lancas17/nrf52-controller/nrf52-controller.kicad_pcb

## KiCad design nrf52-controller.kicad_pcb (2024-05-02)

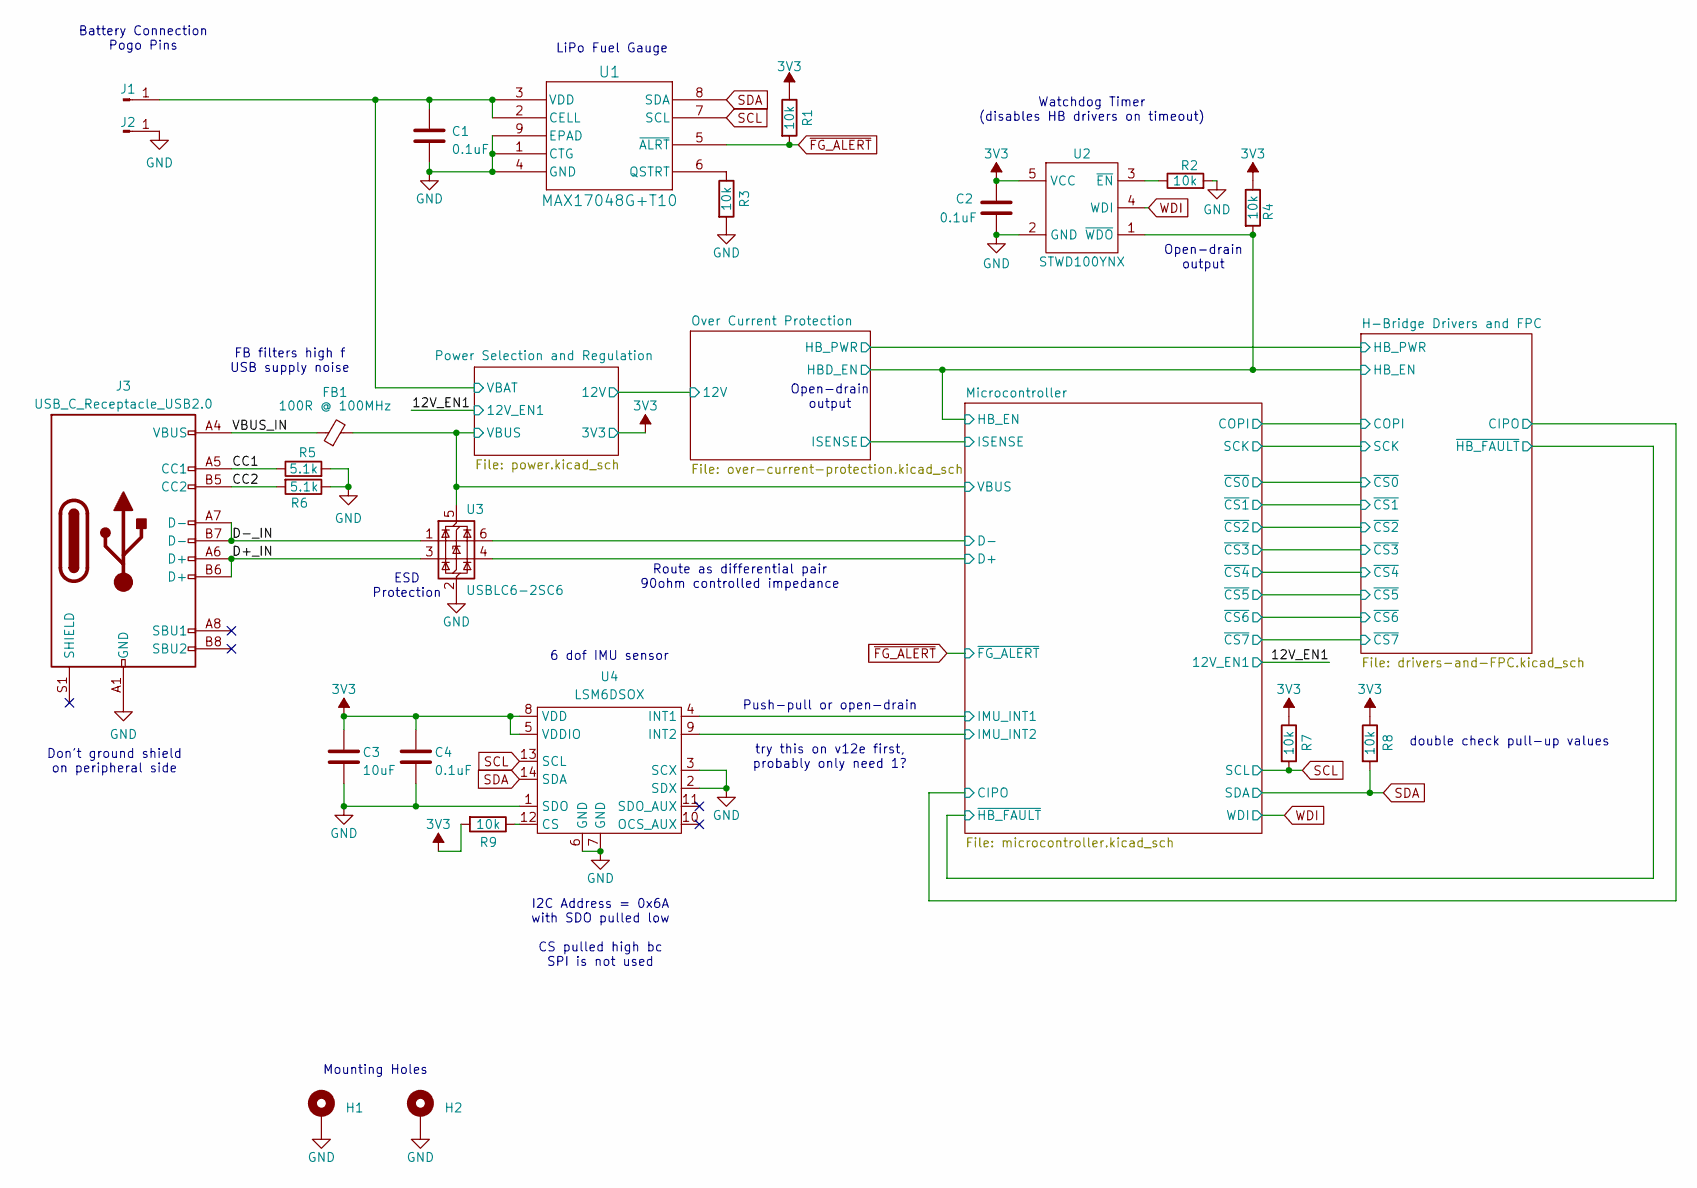
[picture p1: schematic nrf52-controller.kicad_sch]

Parts:
C1, C2, C4: 0.1uF; C_0402_1005Metric; JLCPCB Part # C880603
C3: 10uF; C_0402_1005Metric; JLCPCB Part # C15525
FB1: 100R @ 100MHz; C_0805_2012Metric; JLCPCB Part # C1015
H1, H2: MountingHole_Pad; MountingHole_1.8mm_M1.6_Pad_TopBottom
J1, J2: Conn_01x01_Pin; POGO_2mm-base_0.9mm-through-hole; JLCPCB Part # C5157348
J3: USB_C_Receptacle_USB2.0; USB_C_Receptacle_G-Switch_GT-USB-7010ASV; JLCPCB Part # C2988369
R1, R2, R3, R4, R7, R8, R9: 10k; R_0402_1005Metric; JLCPCB Part # C25744
R5, R6: 5.1k; R_0402_1005Metric; JLCPCB Part # C25905
U1: MAX17048G+T10; 21-0168E_T822-3_MXM; JLCPCB Part # C2682616
U2: STWD100YNX; SOT-23-5; JLCPCB Part # C1354132
U3: USBLC6-2SC6; SOT-23-6
U4: LSM6DSOX; LGA-14L_STM; JLCPCB Part # C481766

Connections:
3V3: C2.1, C3.1, C4.1, R1.1, R4.1, R7.1, R8.1, R9.2, U2.5 (VCC), U4.5 (VDDIO), U4.8 (VDD); also elsewhere on the board
/CC1: J3.A5 (CC1), R5.1
/CC2: J3.B5 (CC2), R6.2
/D+_IN: J3.A6 (D+), J3.B6 (D+), U3.3 (I/O2)
/D-_IN: J3.A7 (D-), J3.B7 (D-), U3.1 (I/O1)
/H-Bridge Drivers and FPC/HB_EN: R4.2, U2.1 (~WDO); also elsewhere on the board
/Microcontroller/D+: U3.4 (I/O2); also elsewhere on the board
/Microcontroller/D-: U3.6 (I/O1); also elsewhere on the board
/Microcontroller/IMU_INT1: U4.4 (INT1); also elsewhere on the board
/Microcontroller/IMU_INT2: U4.9 (INT2); also elsewhere on the board
/Microcontroller/VBUS: FB1.2, U3.5 (VBUS); also elsewhere on the board
/Power Selection and Regulation/VBAT: C1.1, J1.1, U1.2 (CELL), U1.3 (VDD); also elsewhere on the board
/VBUS_IN: FB1.1, J3.A4 (VBUS), J3.A9 (VBUS), J3.B4 (VBUS), J3.B9 (VBUS)
GND: C1.2, C2.2, C3.2, C4.2, H1.1, H2.1, J2.1, J3.A1 (GND), J3.A12 (GND), J3.B1 (GND), J3.B12 (GND), R2.2, R3.2, R5.2, R6.1, U1.1 (CTG), U1.4 (GND), U1.9 (EPAD), U2.2 (GND), U3.2 (GND), U4.1 (SDO), U4.2 (SDX), U4.3 (SCX), U4.6 (GND), U4.7 (GND); also elsewhere on the board
unnamed: R3.1, U1.6 (QSTRT)
unnamed: R2.1, U2.3 (~EN)
unnamed: R9.1, U4.12 (CS)
SCL: R7.2, U1.7 (SCL), U4.13 (SCL); also elsewhere on the board
SDA: R8.2, U1.8 (SDA), U4.14 (SDA); also elsewhere on the board
WDI: U2.4 (WDI); also elsewhere on the board
~FG_ALERT: R1.2, U1.5 (~ALRT); also elsewhere on the board

Notes on the sheet:
Watchdog Timer (disables HB drivers on timeout)
try this on v12e first, probably only need 1?
double check pull-up values
LiPo Fuel Gauge
ESD Protection
6 dof IMU sensor
Don't ground shield on peripheral side
Open-drain output
I2C Address = 0x6A with SDO pulled low CS pulled high bc SPI is not used
Mounting Holes
Battery Connection Pogo Pins
Route as differential pair 90ohm controlled impedance
Push-pull or open-drain
FB filters high f USB supply noise

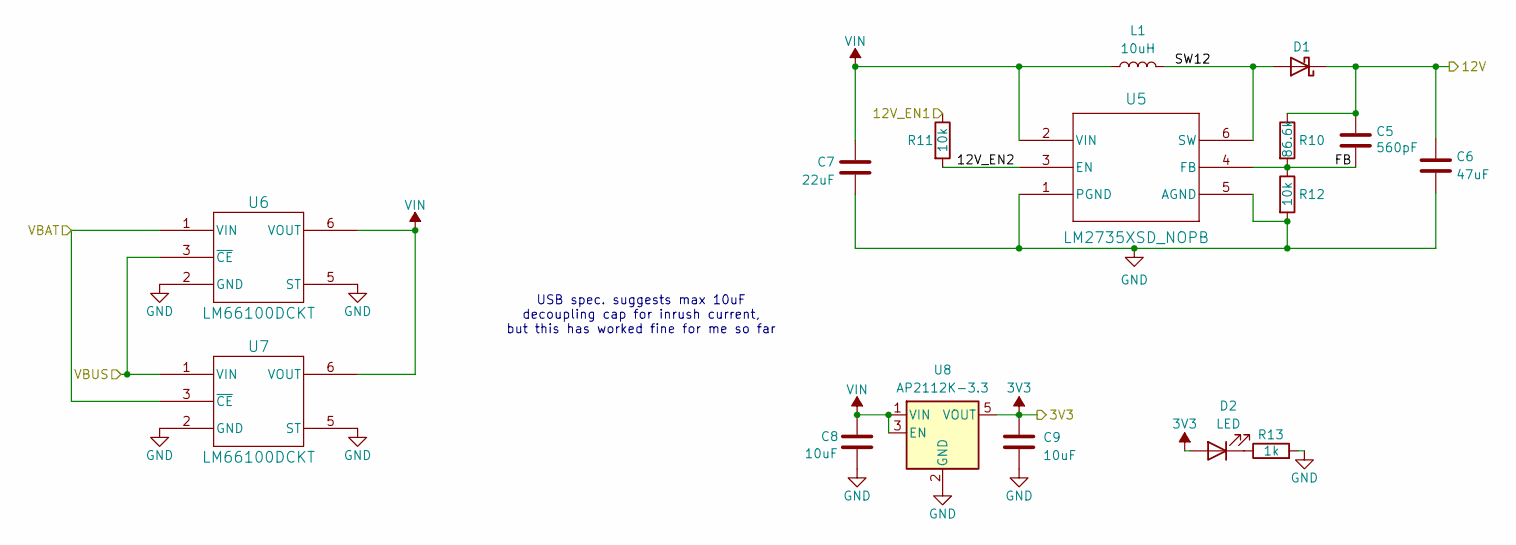
[picture p2: schematic power.kicad_sch]

Parts:
C5: 560pF; C_0402_1005Metric; JLCPCB Part # C464953
C6: 47uF; C_1210_3225Metric; JLCPCB Part # C77101
C7: 22uF; C_0805_2012Metric; JLCPCB Part # C45783
C8, C9: 10uF; C_0603_1608Metric; JLCPCB Part # C19702
D1: D_Schottky; D_SOD-123F; JLCPCB Part # C725481
D2: LED; LED_0603_RA_TJ-S1706CL6T5ALC9Y-A5; JLCPCB Part # C1322337
L1: 10uH; IND_357100_WRE; JLCPCB Part # C2651175
R10: 86.6k; R_0402_1005Metric; JLCPCB Part # C881092
R11, R12: 10k; R_0402_1005Metric; JLCPCB Part # C25744
R13: 1k; R_0402_1005Metric; JLCPCB Part # C11702
U5: LM2735XSD_NOPB; Texas_PWSON-N6; JLCPCB Part # C2072080
U6, U7: LM66100DCKT; SC70_DCK6_TI; JLCPCB Part # C2832141
U8: AP2112K-3.3; SOT-23-5

Connections:
3V3: C9.1, D2.2 (A), U8.5 (VOUT); also elsewhere on the board
/12V_EN1: R11.1; also elsewhere on the board
/Microcontroller/VBUS: U6.3 (~CE), U7.1 (VIN); also elsewhere on the board
/Over Current Protection/12V: C5.2, C6.2, D1.1 (K), R10.1; also elsewhere on the board
/Power Selection and Regulation/12V_EN2: R11.2, U5.3 (EN)
/Power Selection and Regulation/FB: C5.1, R10.2, R12.1, U5.4 (FB)
/Power Selection and Regulation/SW12: D1.2 (A), L1.2, U5.6 (SW)
/Power Selection and Regulation/VBAT: U6.1 (VIN), U7.3 (~CE); also elsewhere on the board
GND: C6.1, C7.2, C8.2, C9.2, R12.2, R13.2, U5.1 (PGND), U5.5 (AGND), U5.7 (EPAD), U6.2 (GND), U6.4 (NC), U6.5 (ST), U7.2 (GND), U7.4 (NC), U7.5 (ST), U8.2 (GND); also elsewhere on the board
unnamed: D2.1 (K), R13.1
VIN: C7.1, C8.1, L1.1, U5.2 (VIN), U6.6 (VOUT), U7.6 (VOUT), U8.1 (VIN), U8.3 (EN)

Notes on the sheet:
USB spec. suggests max 10uF decoupling cap for inrush current, but this has worked fine for me so far

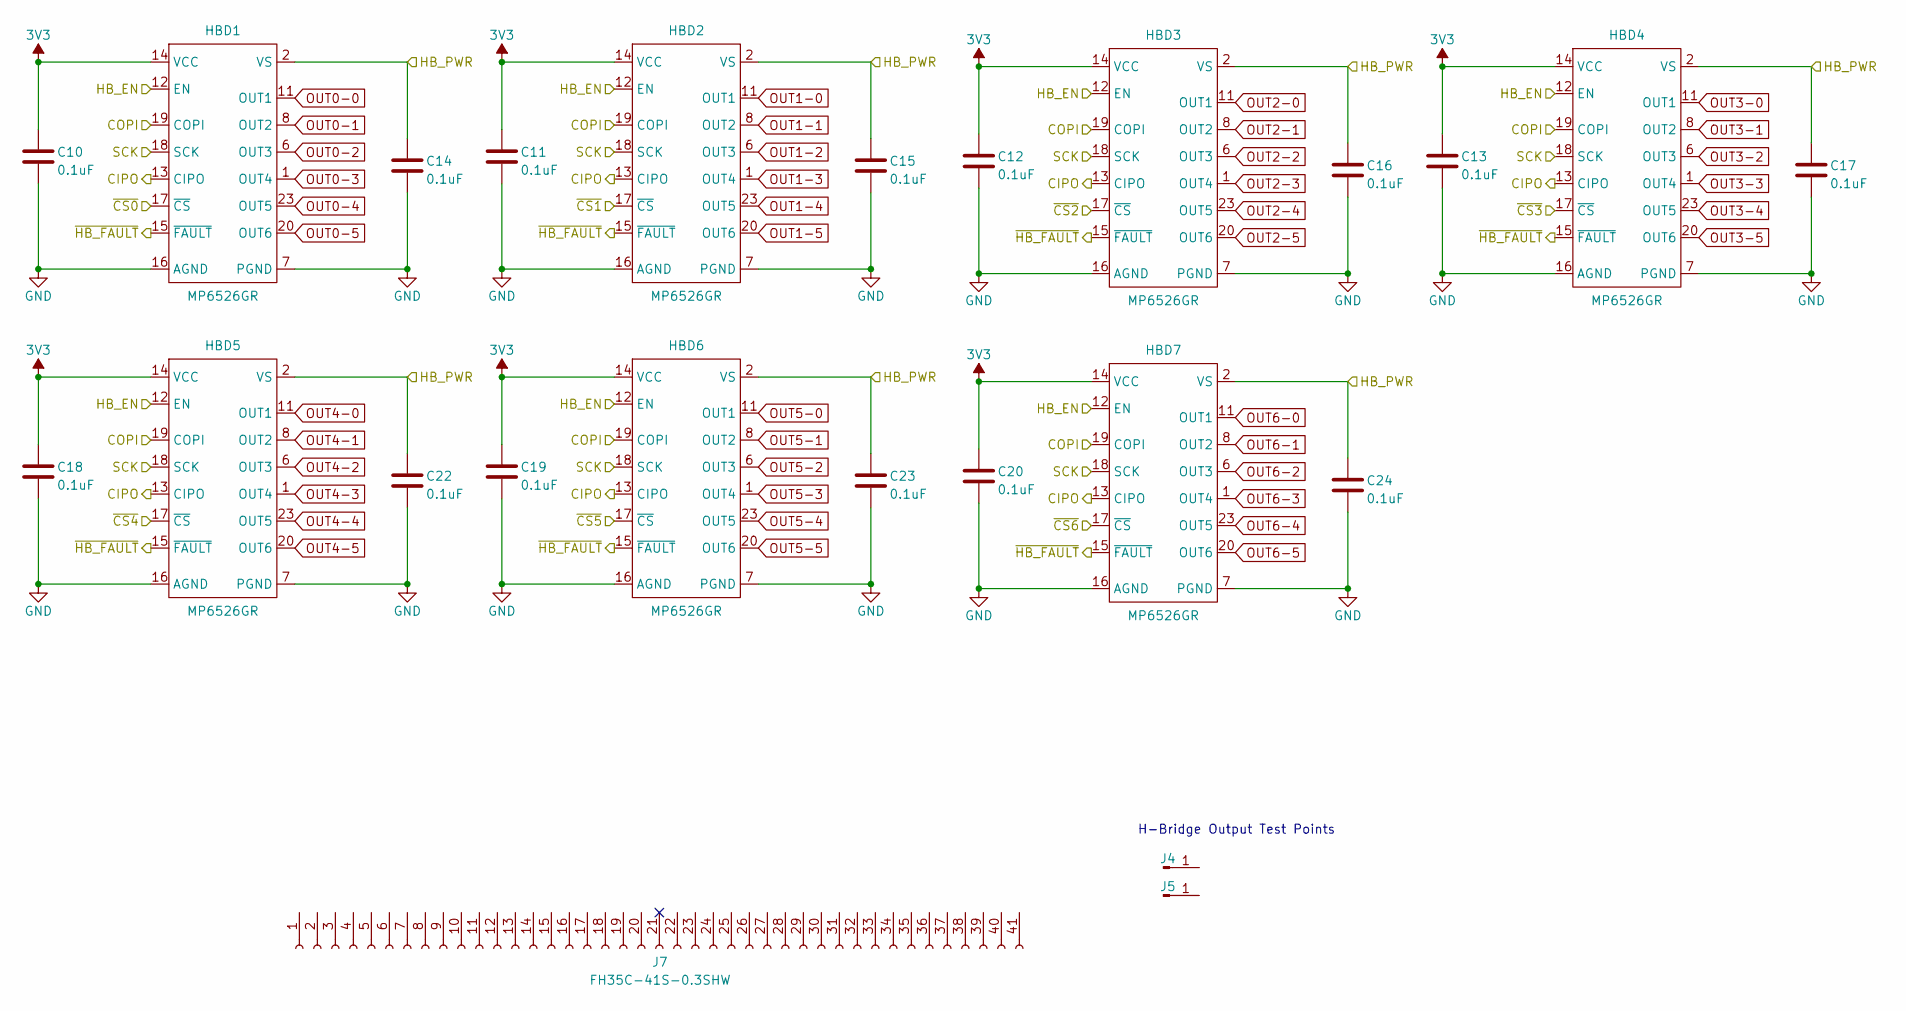
[picture p3: schematic drivers-and-FPC.kicad_sch]

Parts:
C10, C11, C12, C13, C14, C15, C16, C17, C18, C19, C20, C22, C23, C24: 0.1uF; C_0402_1005Metric; JLCPCB Part # C880603
HBD1, HBD2, HBD3, HBD4, HBD5, HBD6, HBD7: MP6526GR; QFN-24-1EP_4x4mm_P0.5mm_EP2.7x2.7mm
J4, J5: Conn_01x01_Pin; TP_1mm
J7: FH35C-41S-0.3SHW; CONN_FH35W-41S-0.3SHW; JLCPCB Part # C424663

Connections:
3V3: C10.1, C11.1, C12.1, C13.1, C18.1, C19.1, C20.1, HBD1.14 (VCC), HBD2.14 (VCC), HBD3.14 (VCC), HBD4.14 (VCC), HBD5.14 (VCC), HBD6.14 (VCC), HBD7.14 (VCC); also elsewhere on the board
/H-Bridge Drivers and FPC/CIPO: HBD1.13 (CIPO), HBD2.13 (CIPO), HBD3.13 (CIPO), HBD4.13 (CIPO), HBD5.13 (CIPO), HBD6.13 (CIPO), HBD7.13 (CIPO); also elsewhere on the board
/H-Bridge Drivers and FPC/COPI: HBD1.19 (COPI), HBD2.19 (COPI), HBD3.19 (COPI), HBD4.19 (COPI), HBD5.19 (COPI), HBD6.19 (COPI), HBD7.19 (COPI); also elsewhere on the board
/H-Bridge Drivers and FPC/HB_EN: HBD1.12 (EN), HBD2.12 (EN), HBD3.12 (EN), HBD4.12 (EN), HBD5.12 (EN), HBD6.12 (EN), HBD7.12 (EN); also elsewhere on the board
/H-Bridge Drivers and FPC/SCK: HBD1.18 (SCK), HBD2.18 (SCK), HBD3.18 (SCK), HBD4.18 (SCK), HBD5.18 (SCK), HBD6.18 (SCK), HBD7.18 (SCK); also elsewhere on the board
/H-Bridge Drivers and FPC/~CS0: HBD1.17 (~CS); also elsewhere on the board
/H-Bridge Drivers and FPC/~CS1: HBD2.17 (~CS); also elsewhere on the board
/H-Bridge Drivers and FPC/~CS2: HBD3.17 (~CS); also elsewhere on the board
/H-Bridge Drivers and FPC/~CS3: HBD4.17 (~CS); also elsewhere on the board
/H-Bridge Drivers and FPC/~CS4: HBD5.17 (~CS); also elsewhere on the board
/H-Bridge Drivers and FPC/~CS5: HBD6.17 (~CS); also elsewhere on the board
/H-Bridge Drivers and FPC/~CS6: HBD7.17 (~CS); also elsewhere on the board
/H-Bridge Drivers and FPC/~HB_FAULT: HBD1.15 (~FAULT), HBD2.15 (~FAULT), HBD3.15 (~FAULT), HBD4.15 (~FAULT), HBD5.15 (~FAULT), HBD6.15 (~FAULT), HBD7.15 (~FAULT); also elsewhere on the board
GND: C10.2, C11.2, C12.2, C13.2, C14.2, C15.2, C16.2, C17.2, C18.2, C19.2, C20.2, C22.2, C23.2, C24.2, HBD1.7 (PGND), HBD1.9 (PGND), HBD1.10 (PGND), HBD1.16 (AGND), HBD1.21 (PGND), HBD1.22 (PGND), HBD1.24 (PGND), HBD1.25 (EPAD), HBD2.7 (PGND), HBD2.9 (PGND), HBD2.10 (PGND), HBD2.16 (AGND), HBD2.21 (PGND), HBD2.22 (PGND), HBD2.24 (PGND), HBD2.25 (EPAD), HBD3.7 (PGND), HBD3.9 (PGND), HBD3.10 (PGND), HBD3.16 (AGND), HBD3.21 (PGND), HBD3.22 (PGND), HBD3.24 (PGND), HBD3.25 (EPAD), HBD4.7 (PGND), HBD4.9 (PGND), HBD4.10 (PGND), HBD4.16 (AGND), HBD4.21 (PGND), HBD4.22 (PGND), HBD4.24 (PGND), HBD4.25 (EPAD), HBD5.7 (PGND), HBD5.9 (PGND), HBD5.10 (PGND), HBD5.16 (AGND), HBD5.21 (PGND), HBD5.22 (PGND), HBD5.24 (PGND), HBD5.25 (EPAD), HBD6.7 (PGND), HBD6.9 (PGND), HBD6.10 (PGND), HBD6.16 (AGND), HBD6.21 (PGND), HBD6.22 (PGND), HBD6.24 (PGND), HBD6.25 (EPAD), HBD7.7 (PGND), HBD7.9 (PGND), HBD7.10 (PGND), HBD7.16 (AGND), HBD7.21 (PGND), HBD7.22 (PGND), HBD7.24 (PGND), HBD7.25 (EPAD); also elsewhere on the board
OUT0-0: HBD1.11 (OUT1)
OUT0-1: HBD1.8 (OUT2)
OUT0-2: HBD1.6 (OUT3)
OUT0-3: HBD1.1 (OUT4)
OUT0-4: HBD1.23 (OUT5)
OUT0-5: HBD1.20 (OUT6)
OUT1-0: HBD2.11 (OUT1)
OUT1-1: HBD2.8 (OUT2)
OUT1-2: HBD2.6 (OUT3)
OUT1-3: HBD2.1 (OUT4)
OUT1-4: HBD2.23 (OUT5)
OUT1-5: HBD2.20 (OUT6)
OUT2-0: HBD3.11 (OUT1)
OUT2-1: HBD3.8 (OUT2)
OUT2-2: HBD3.6 (OUT3)
OUT2-3: HBD3.1 (OUT4)
OUT2-4: HBD3.23 (OUT5)
OUT2-5: HBD3.20 (OUT6)
OUT3-0: HBD4.11 (OUT1)
OUT3-1: HBD4.8 (OUT2)
OUT3-2: HBD4.6 (OUT3)
OUT3-3: HBD4.1 (OUT4)
OUT3-4: HBD4.23 (OUT5)
OUT3-5: HBD4.20 (OUT6)
OUT4-0: HBD5.11 (OUT1)
OUT4-1: HBD5.8 (OUT2)
OUT4-2: HBD5.6 (OUT3)
OUT4-3: HBD5.1 (OUT4)
OUT4-4: HBD5.23 (OUT5)
OUT4-5: HBD5.20 (OUT6)
OUT5-0: HBD6.11 (OUT1)
OUT5-1: HBD6.8 (OUT2)
OUT5-2: HBD6.6 (OUT3)
OUT5-3: HBD6.1 (OUT4)
OUT5-4: HBD6.23 (OUT5)
OUT5-5: HBD6.20 (OUT6)
OUT6-0: HBD7.11 (OUT1)
OUT6-1: HBD7.8 (OUT2)
OUT6-2: HBD7.6 (OUT3)
OUT6-3: HBD7.1 (OUT4)
OUT6-4: HBD7.23 (OUT5)
OUT6-5: HBD7.20 (OUT6)
VS: C14.1, C15.1, C16.1, C17.1, C22.1, C23.1, C24.1, HBD1.2 (VS), HBD1.3 (VS), HBD1.4 (VS), HBD1.5 (VS), HBD2.2 (VS), HBD2.3 (VS), HBD2.4 (VS), HBD2.5 (VS), HBD3.2 (VS), HBD3.3 (VS), HBD3.4 (VS), HBD3.5 (VS), HBD4.2 (VS), HBD4.3 (VS), HBD4.4 (VS), HBD4.5 (VS), HBD5.2 (VS), HBD5.3 (VS), HBD5.4 (VS), HBD5.5 (VS), HBD6.2 (VS), HBD6.3 (VS), HBD6.4 (VS), HBD6.5 (VS), HBD7.2 (VS), HBD7.3 (VS), HBD7.4 (VS), HBD7.5 (VS); also elsewhere on the board

Notes on the sheet:
H-Bridge Output Test Points

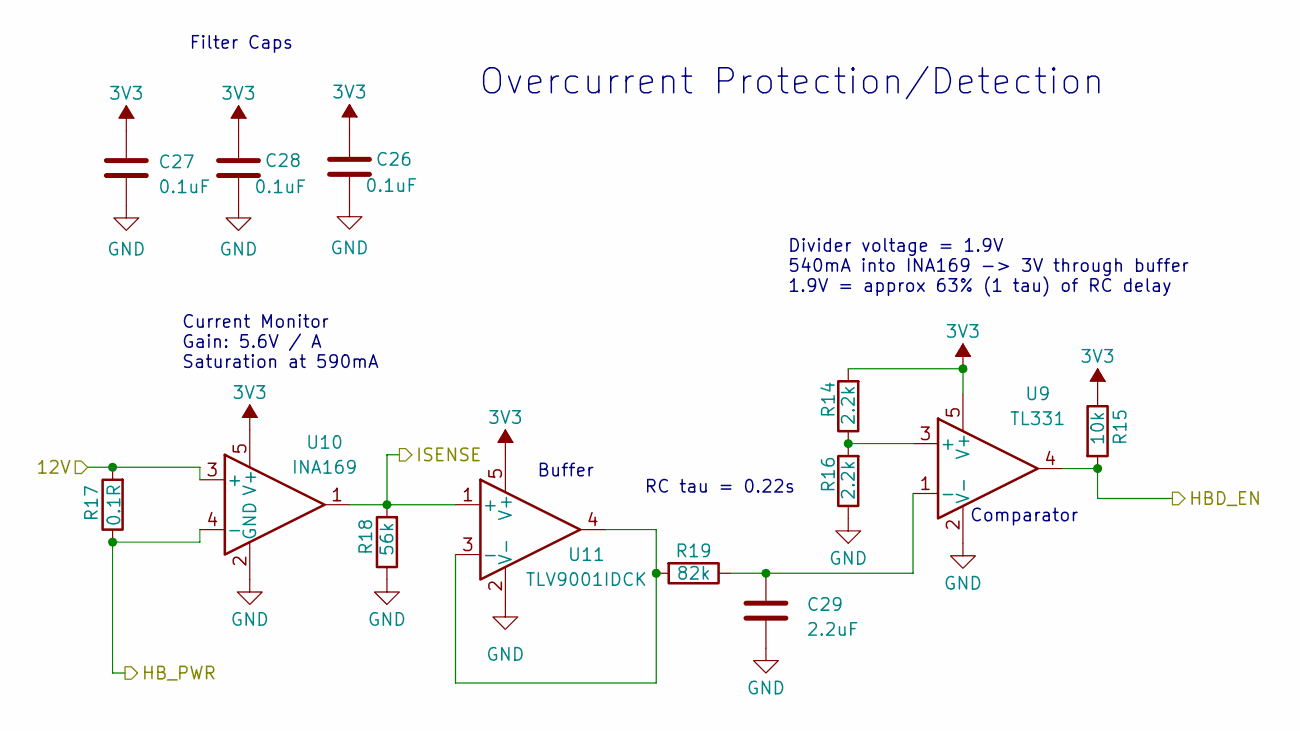
[picture p4: schematic over-current-protection.kicad_sch]

Parts:
C26, C27, C28: 0.1uF; C_0402_1005Metric; JLCPCB Part # C880603
C29: 2.2uF; C_0402_1005Metric; JLCPCB Part # C12530
R14, R16: 2.2k; R_0402_1005Metric; JLCPCB Part # C25879
R15: 10k; R_0402_1005Metric; JLCPCB Part # C25744
R17: 0.1R; R_1206_3216Metric; JLCPCB Part # C25334
R18: 56k; R_0402_1005Metric
R19: 82k; R_0402_1005Metric; JLCPCB Part # C4142
U9: TL331; SOT-23-5; JLCPCB Part # C2877827
U10: INA169; SOT-23-5; JLCPCB Part # C44322
U11: TLV9001IDCK; SOT-353_SC-70-5; JLCPCB Part # C398362

Connections:
3V3: C26.1, C27.1, C28.1, R14.2, R15.1, U9.5 (V+), U10.5 (V+), U11.5 (V+); also elsewhere on the board
/H-Bridge Drivers and FPC/HB_EN: R15.2, U9.4; also elsewhere on the board
/Microcontroller/ISENSE: R18.2, U10.1, U11.1 (+); also elsewhere on the board
/Over Current Protection/12V: R17.2, U10.3 (+); also elsewhere on the board
GND: C26.2, C27.2, C28.2, C29.2, R16.1, R18.1, U9.2 (V-), U10.2 (GND), U11.2 (V-); also elsewhere on the board
unnamed: R14.1, R16.2, U9.3 (+)
unnamed: C29.1, R19.1, U9.1 (-)
unnamed: R19.2, U11.3 (-), U11.4
VS: R17.1, U10.4 (-); also elsewhere on the board

Notes on the sheet:
Overcurrent Protection/Detection
Buffer
RC tau = 0.22s
Filter Caps
Divider voltage = 1.9V 540mA into INA169 -> 3V through buffer 1.9V = approx 63% (1 tau) of RC delay
Comparator
Current Monitor Gain: 5.6V / A Saturation at 590mA

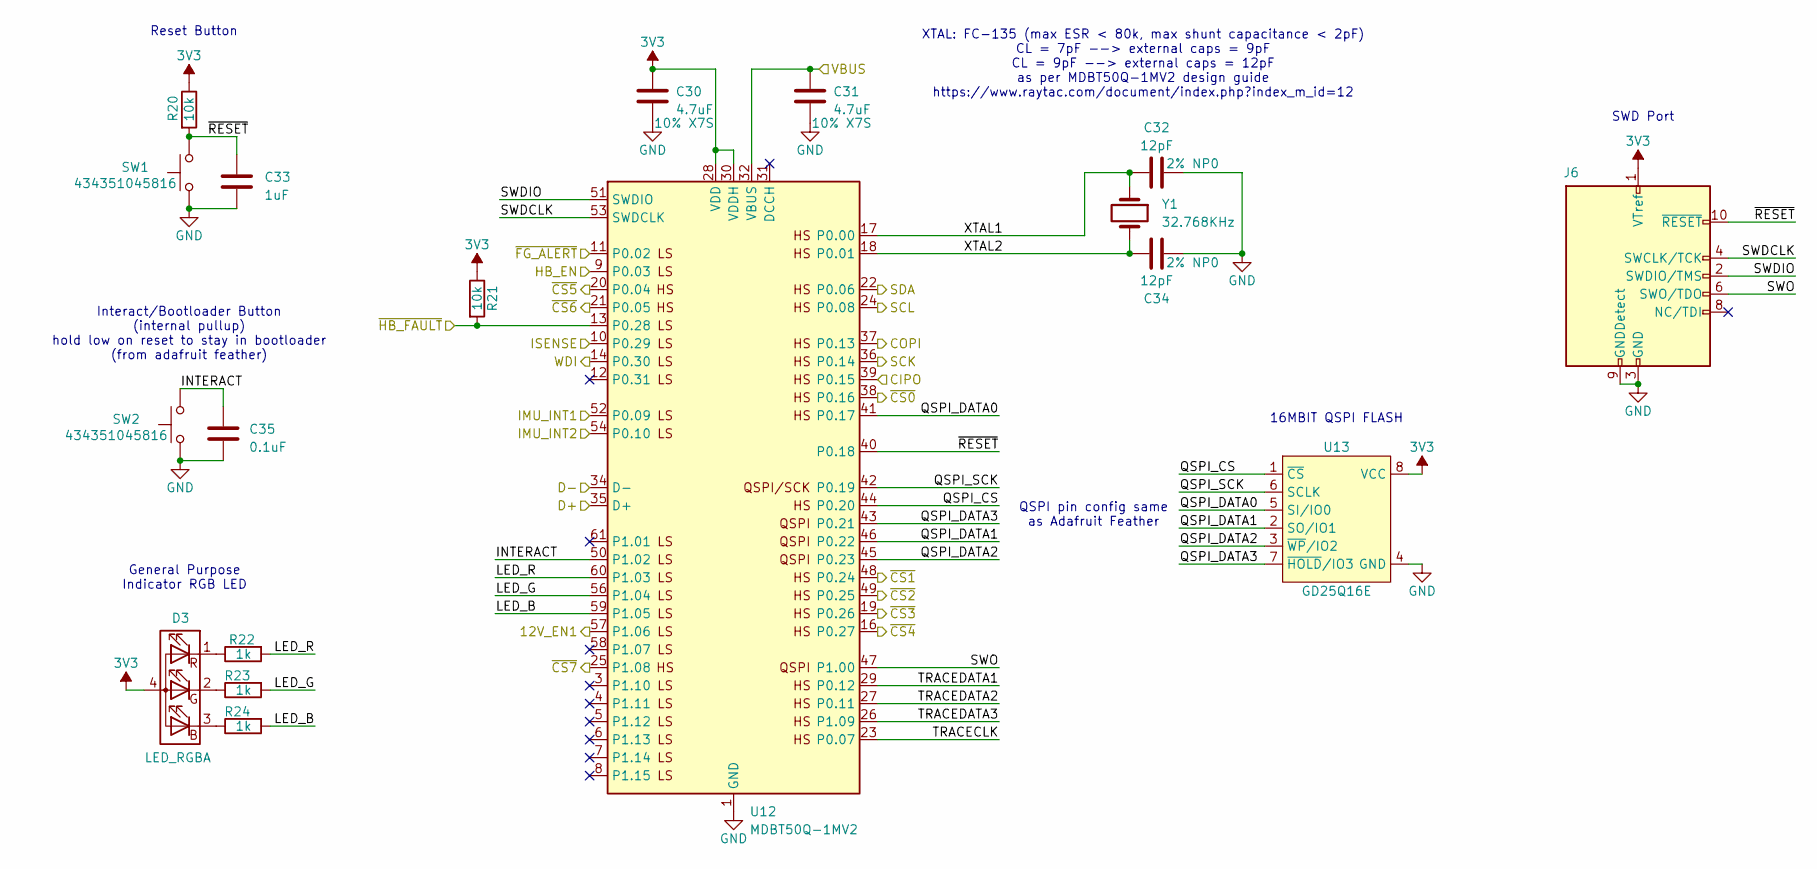
[picture p5: schematic microcontroller.kicad_sch]

Parts:
C30, C31: 4.7uF; C_0603_1608Metric
C32, C34: 12pF; C_0402_1005Metric
C33: 1uF; C_0402_1005Metric; JLCPCB Part # C52923
C35: 0.1uF; C_0402_1005Metric; JLCPCB Part # C880603
D3: LED_RGBA; RGBA_LTST-S310F3WT; JLCPCB Part # C284951
J6: Conn_ARM_JTAG_SWD_10; SWD_2x10_target-pads
R20, R21: 10k; R_0402_1005Metric; JLCPCB Part # C25744
R22, R23, R24: 1k; R_0402_1005Metric; JLCPCB Part # C11702
SW1, SW2: 434351045816; SW_Wurth_434351045816; JLCPCB Part # C5337107
U12: MDBT50Q-1MV2; Raytac_MDBT50Q
U13: GD25Q16E; WSON-8_3x2mm_EP-0.2x2mm
Y1: 32.768KHz; Crystal_SMD_3215-2Pin_3.2x1.5mm

Connections:
3V3: C30.1, D3.4 (A), J6.1 (VTref), R20.1, R21.1, U12.28 (VDD), U12.30 (VDDH), U13.8 (VCC); also elsewhere on the board
/12V_EN1: U12.57 (P1.06); also elsewhere on the board
/H-Bridge Drivers and FPC/CIPO: U12.39 (P0.15); also elsewhere on the board
/H-Bridge Drivers and FPC/COPI: U12.37 (P0.13); also elsewhere on the board
/H-Bridge Drivers and FPC/HB_EN: U12.9 (P0.03); also elsewhere on the board
/H-Bridge Drivers and FPC/SCK: U12.36 (P0.14); also elsewhere on the board
/H-Bridge Drivers and FPC/~CS0: U12.38 (P0.16); also elsewhere on the board
/H-Bridge Drivers and FPC/~CS1: U12.48 (P0.24); also elsewhere on the board
/H-Bridge Drivers and FPC/~CS2: U12.49 (P0.25); also elsewhere on the board
/H-Bridge Drivers and FPC/~CS3: U12.19 (P0.26); also elsewhere on the board
/H-Bridge Drivers and FPC/~CS4: U12.16 (P0.27); also elsewhere on the board
/H-Bridge Drivers and FPC/~CS5: U12.20 (P0.04); also elsewhere on the board
/H-Bridge Drivers and FPC/~CS6: U12.21 (P0.05); also elsewhere on the board
/H-Bridge Drivers and FPC/~HB_FAULT: R21.2, U12.13 (P0.28); also elsewhere on the board
/Microcontroller/D+: U12.35 (D+); also elsewhere on the board
/Microcontroller/D-: U12.34 (D-); also elsewhere on the board
/Microcontroller/IMU_INT1: U12.52 (P0.09); also elsewhere on the board
/Microcontroller/IMU_INT2: U12.54 (P0.10); also elsewhere on the board
/Microcontroller/INTERACT: C35.1, SW2.2, U12.50 (P1.02)
/Microcontroller/ISENSE: U12.10 (P0.29); also elsewhere on the board
/Microcontroller/LED_B: R24.2, U12.59 (P1.05)
/Microcontroller/LED_G: R23.2, U12.56 (P1.04)
/Microcontroller/LED_R: R22.2, U12.60 (P1.03)
/Microcontroller/QSPI_CS: U12.44 (P0.20), U13.1 (~CS)
/Microcontroller/QSPI_DATA0: U12.41 (P0.17), U13.5 (SI/IO0)
/Microcontroller/QSPI_DATA1: U12.46 (P0.22), U13.2 (SO/IO1)
/Microcontroller/QSPI_DATA2: U12.45 (P0.23), U13.3 (~WP/IO2)
/Microcontroller/QSPI_DATA3: U12.43 (P0.21), U13.7 (~HOLD/IO3)
/Microcontroller/QSPI_SCK: U12.42 (P0.19), U13.6 (SCLK)
/Microcontroller/SWDCLK: J6.4 (SWCLK/TCK), U12.53 (SWDCLK)
/Microcontroller/SWDIO: J6.2 (SWDIO/TMS), U12.51 (SWDIO)
/Microcontroller/SWO: J6.6 (SWO/TDO), U12.47 (P1.00)
/Microcontroller/TRACECLK: U12.23 (P0.07)
/Microcontroller/TRACEDATA1: U12.29 (P0.12)
/Microcontroller/TRACEDATA2: U12.27 (P0.11)
/Microcontroller/TRACEDATA3: U12.26 (P1.09)
/Microcontroller/VBUS: C31.1, U12.32 (VBUS); also elsewhere on the board
/Microcontroller/XTAL1: C32.1, U12.17 (P0.00), Y1.1
/Microcontroller/XTAL2: C34.2, U12.18 (P0.01), Y1.2
/Microcontroller/~CS7: U12.25 (P1.08)
/Microcontroller/~RESET: C33.1, J6.10 (~RESET), R20.2, SW1.2, U12.40 (P0.18)
GND: C30.2, C31.2, C32.2, C33.2, C34.1, C35.2, J6.3 (GND), J6.5 (GND), J6.9 (GNDDetect), SW1.1, SW2.1, U12.1 (GND), U12.2 (GND), U12.15 (GND), U12.33 (GND), U12.55 (GND), U13.4 (GND), U13.9 (EPAD); also elsewhere on the board
unnamed: D3.3 (BK), R24.1
unnamed: D3.2 (GK), R23.1
unnamed: D3.1 (RK), R22.1
SCL: U12.24 (P0.08); also elsewhere on the board
SDA: U12.22 (P0.06); also elsewhere on the board
WDI: U12.14 (P0.30); also elsewhere on the board
~FG_ALERT: U12.11 (P0.02); also elsewhere on the board

Notes on the sheet:
XTAL: FC-135 (max ESR < 80k, max shunt capacitance < 2pF) CL = 7pF --> external caps = 9pF CL = 9pF --> external caps = 12pF as per MDBT50Q-1MV2 design guide https://www.raytac.com/document/index.php?index_m_id=12
16MBIT QSPI FLASH
QSPI pin config same as Adafruit Feather
SWD Port
Reset Button
General Purpose Indicator RGB LED
Interact/Bootloader Button (internal pullup) hold low on reset to stay in bootloader (from adafruit feather)

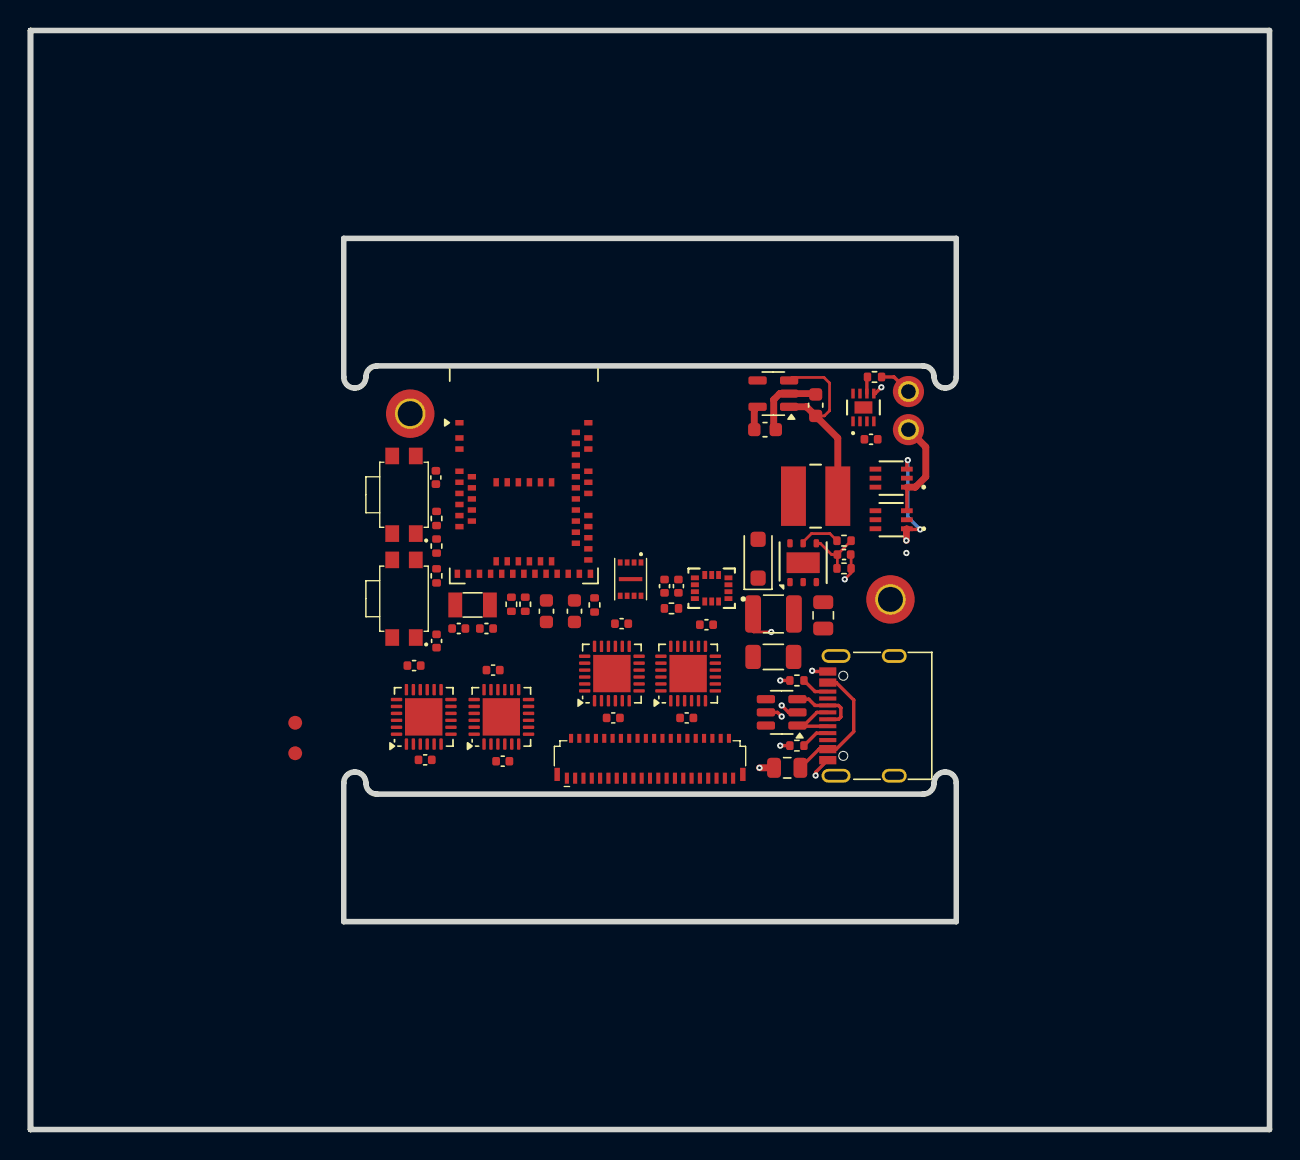
[picture p6: board nrf52-controller.kicad_pcb from above]

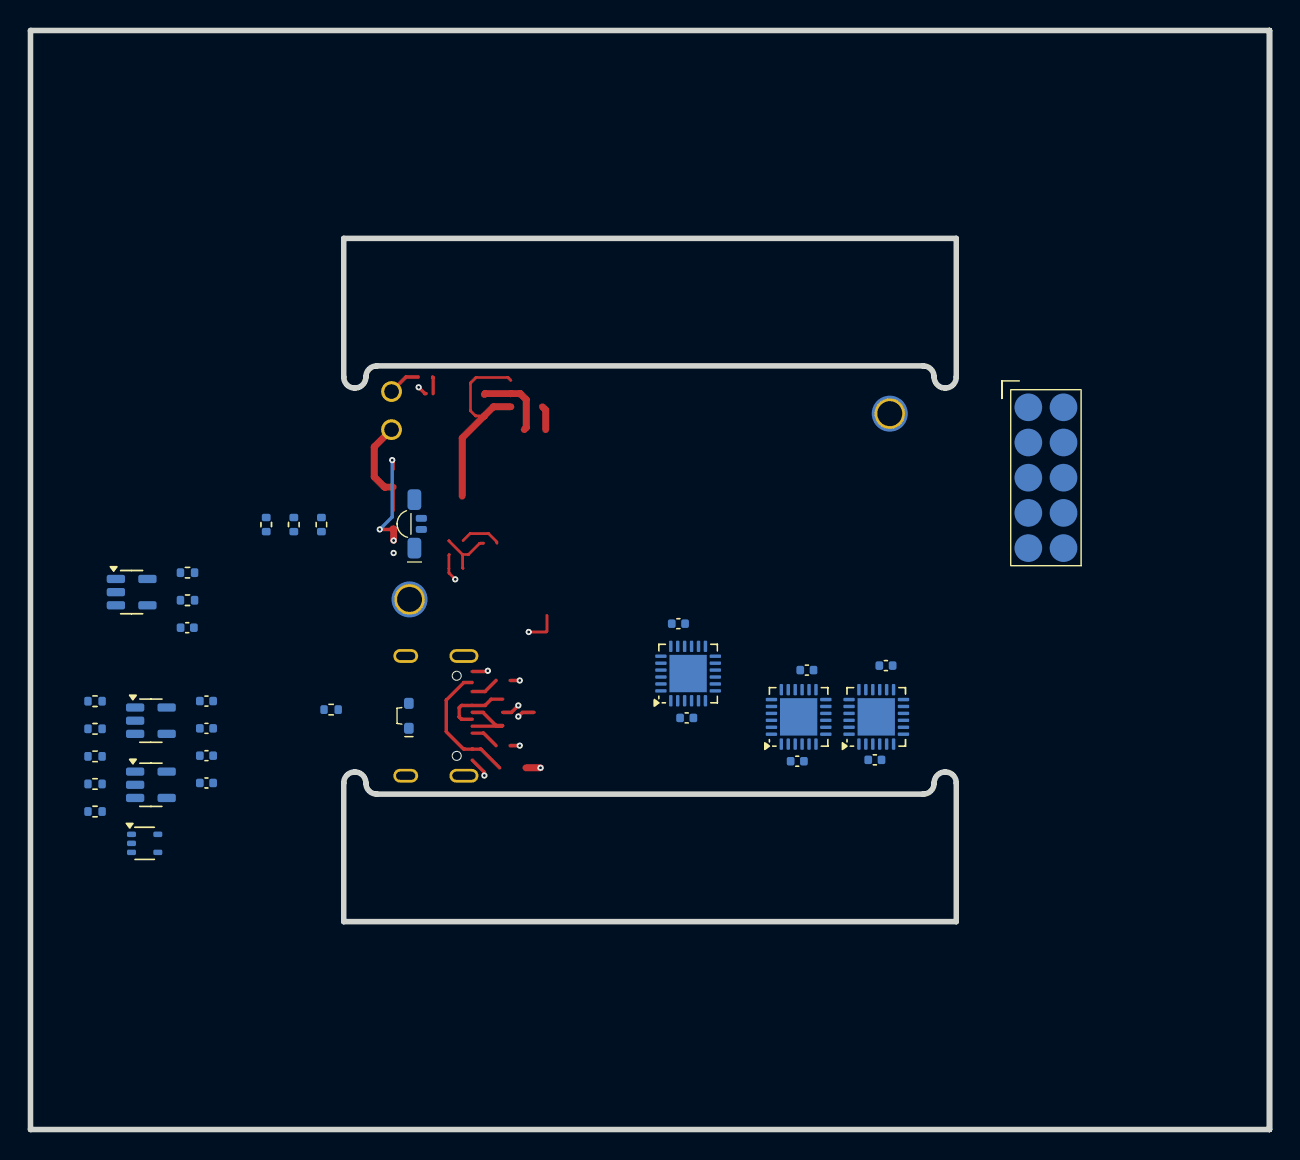
[picture p7: board nrf52-controller.kicad_pcb from below]

Board: 8 copper layers, 89.4 x 79.3 mm, 94 parts (32 on the bottom side), 63 nets.
