lancas17/nrf52-controller/(commit log)

2024-04-11 initial commit - sch draft WIP
    [drivers-and-FPC.kicad_sch, microcontroller.kicad_sch, nrf52-controller.kicad_pcb, nrf52-controller.kicad_sch, over-current-protection.kicad_sch, power.kicad_sch]
2024-04-13 schematic rough draft except fpc
    [drivers-and-FPC.kicad_sch, microcontroller.kicad_sch, nrf52-controller.kicad_sch, power.kicad_sch]
2024-04-13 schematic draft 2; no FPC connections, no testpoints
    [drivers-and-FPC.kicad_sch, microcontroller.kicad_sch, nrf52-controller.kicad_sch, over-current-protection.kicad_sch, power.kicad_sch]
2024-04-16 layout start
    [drivers-and-FPC.kicad_sch, microcontroller.kicad_sch, nrf52-controller.kicad_pcb, nrf52-controller.kicad_sch, over-current-protection.kicad_sch, power.kicad_sch]
2024-05-02 separated smaller board layout variant
    [nrf52-controller.kicad_pcb, nrf52-controller_smaller-board.kicad_pcb]
